jagobandhusome/STM32_OBC_Cube_Sat_Firmware/CubeSat_OBC_Assets/console.png

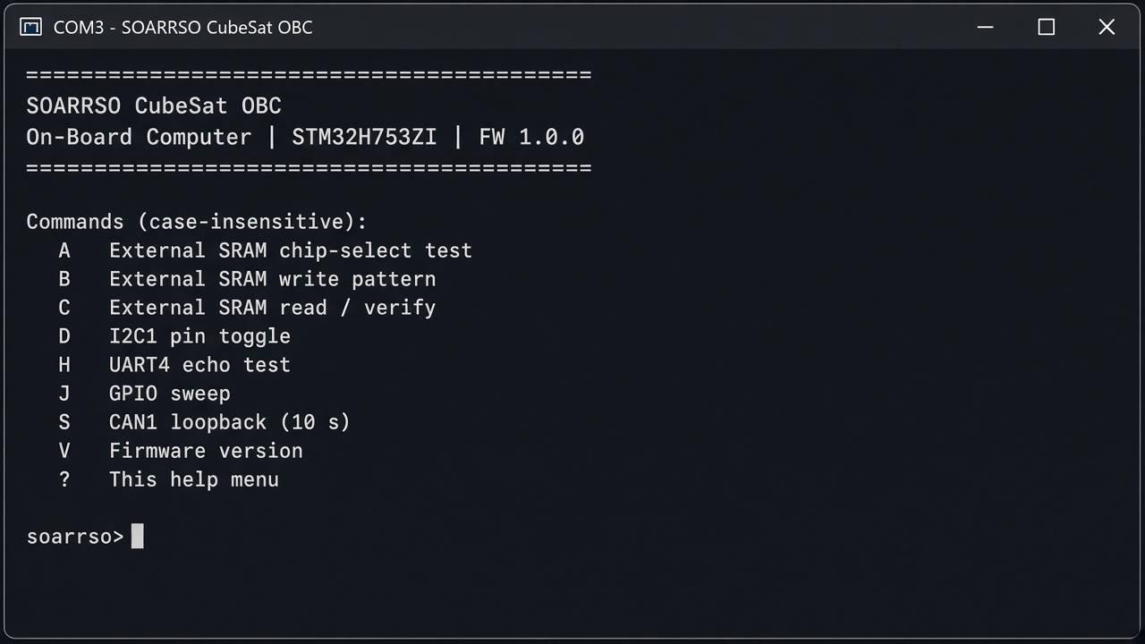
CubeSat_OBC_Assets/console.png
