jagobandhusome/STM32_OBC_Cube_Sat_Firmware/CubeSat_OBC_Hardware/CAD/CubeSat_OBC_PCB.brd

## EAGLE design CubeSat_OBC_Hardware/CAD/CubeSat_OBC_PCB.brd (2026-09-12)

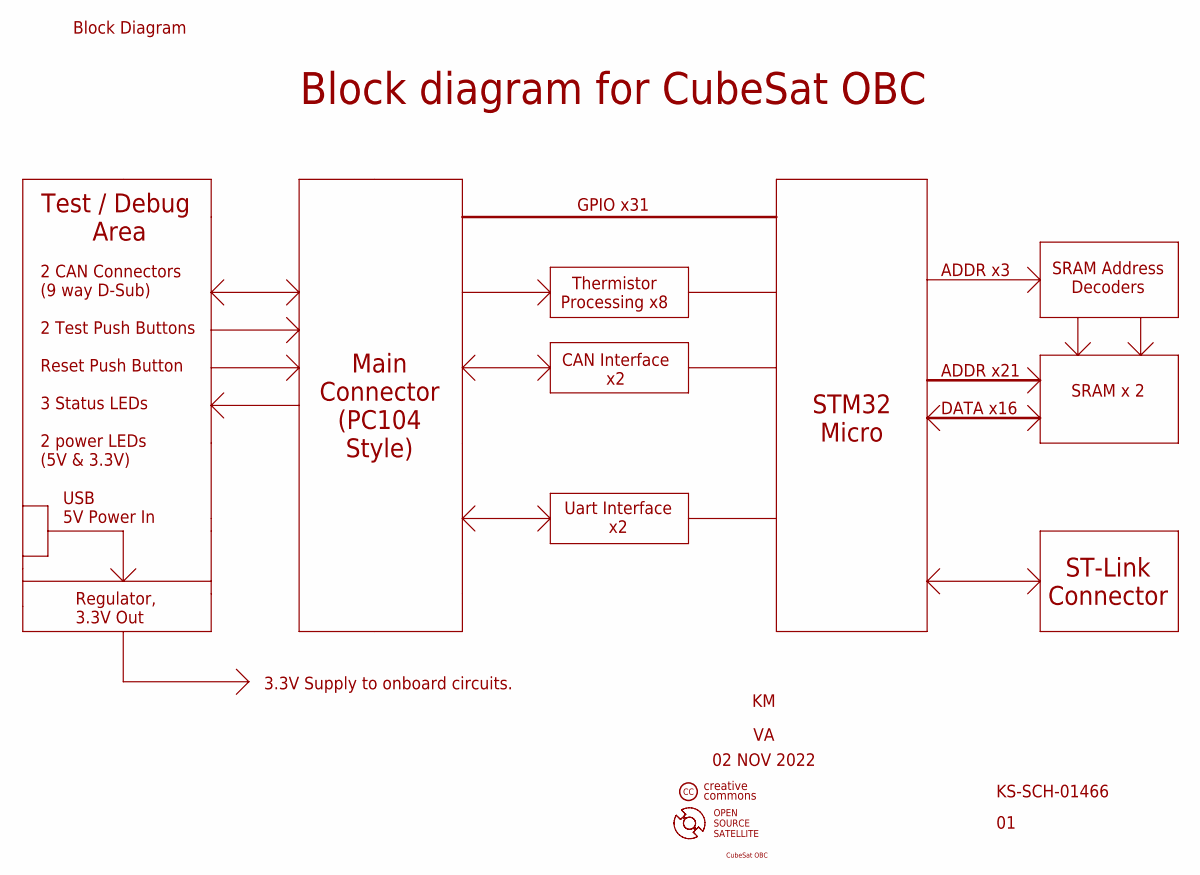
[picture p2: schematic CubeSat_OBC_Schematic.sch, sheet 1, Block Diagram]

Notes on the sheet:
Block Diagram
Main Connector (PC104 Style)
STM32 Micro
Thermistor Processing x8
CAN Interface x2
Uart Interface x2
KS-SCH-01466
SRAM Address Decoders
SRAM x 2
ST-Link Connector
ADDR x21
DATA x16
ADDR x3
GPIO x31
Block diagram for CubeSat OBC
02 NOV 2022
Test / Debug Area
Regulator, 3.3V Out
USB 5V Power In
3.3V Supply to onboard circuits.
2 CAN Connectors (9 way D-Sub) 2 Test Push Buttons Reset Push Button 3 Status LEDs 2 power LEDs (5V & 3.3V)
OPEN SOURCE SATELLITE
creative commons
CubeSat OBC

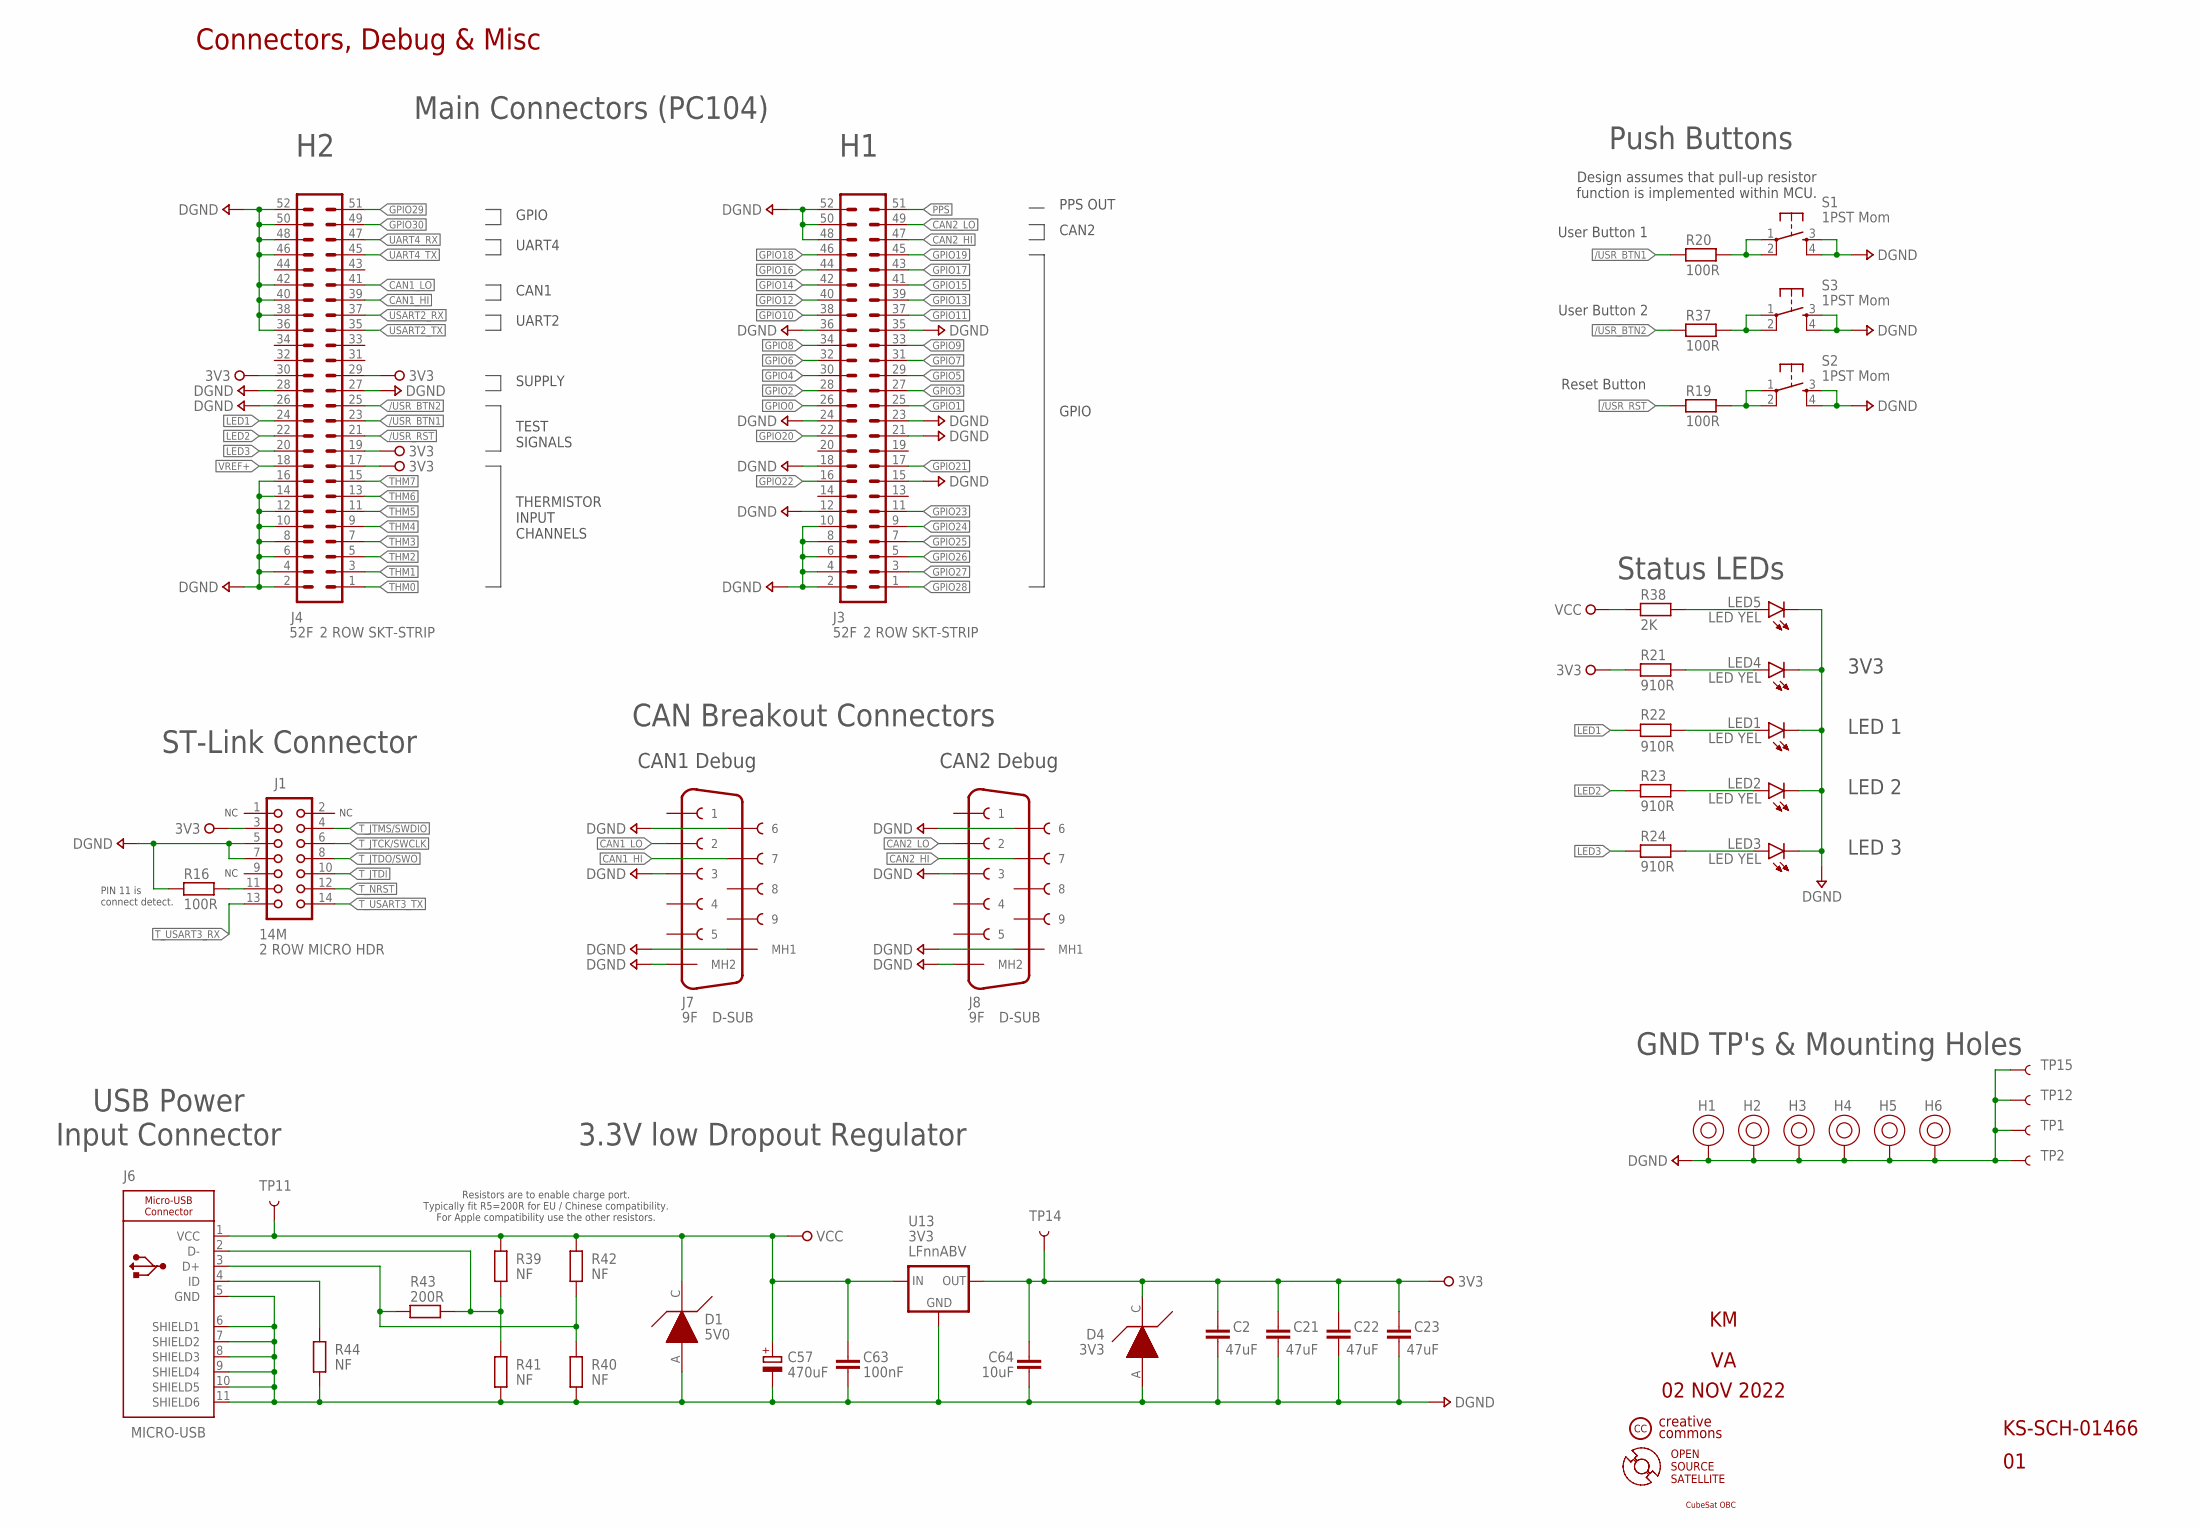
[picture p3: schematic CubeSat_OBC_Schematic.sch, sheet 2, Connectors & Misc]

Parts:
C2, C21, C22, C23: 47uF; CAPC3225X135_1210
C57: 470uF; CAP_ELECT_RADIAL_D10_H12.5_P5
C63: 100nF; CAP_CHIP_0805
C64: 10uF; CAPC3225X135_1210
D1: 5V0; SOD323
D4: 3V3; SOD323
H1, H2, H3, H4, H5, H6: NF; HOLE-PTH-3.2-6.35
J1: 14M; HDRV14W41P127_2X7_FTSH
J3, J4: 52F; HDRVR52W64P254_2X26_6655X495X1105B
J6: CNRP105A_MICRO-USB_90DEG; CON_MICRO_USB_FEMALE
J7, J8: 9F; LD09S24A4GV00LF
LED1, LED2, LED3, LED4, LED5: OPTL102A_LED_YELLOW_0805_120DEG; LED_CHIP_0805
R16, R19, R20, R37: 100R; RES_CHIP_0805
R21, R22, R23, R24: 910R; RES_CHIP_0805
R38: 2K; RES_CHIP_0805
R39, R40, R41, R42, R44: NF; RES_CHIP_0805
R43: 200R; RES_CHIP_0805
S1, S2, S3: SWTA100A_1PST_SMD_MOMENTARY_PUSH-BUTTON; TACTILE_SWITCH_SMD_5.2MM
TP1, TP2, TP11, TP12, TP14, TP15: NF; TP-40TH
U13: 3V3; TO220L1A

Connections:
3V3: C2.1, C21.1, C22.1, C23.1, C64.1, D4.C (K), J1.3, J4.17, J4.19, J4.29, J4.30, R21.1, TP14.P$1, U13.3 (OUT); also elsewhere on the board
/USR_BTN1: J4.23, R20.2; also elsewhere on the board
/USR_BTN2: J4.25, R37.2; also elsewhere on the board
/USR_RST: J4.21, R19.2; also elsewhere on the board
CAN1_HI: J4.39, J7.7; also elsewhere on the board
CAN1_LO: J4.41, J7.2; also elsewhere on the board
CAN2_HI: J3.47, J8.7; also elsewhere on the board
CAN2_LO: J3.49, J8.2; also elsewhere on the board
DGND: C2.2, C21.2, C22.2, C23.2, C57.2 (-), C63.2, C64.2, D1.A, D4.A, H1.P$1, H2.P$1, H3.P$1, H4.P$1, H5.P$1, H6.P$1, J1.5, J1.7, J3.2, J3.4, J3.6, J3.8, J3.10, J3.12, J3.15, J3.18, J3.21, J3.23, J3.24, J3.35, J3.36, J3.48, J3.50, J3.52, J4.2, J4.4, J4.6, J4.8, J4.10, J4.12, J4.14, J4.16, J4.26, J4.27, J4.28, J4.36, J4.38, J4.40, J4.42, J4.46, J4.48, J4.50, J4.52, J6.5 (GND), J6.6 (SHIELD1), J6.7 (SHIELD2), J6.8 (SHIELD3), J6.9 (SHIELD4), J6.10 (SHIELD5), J6.11 (SHIELD6), J7.3, J7.6, J7.MH1 (MH2), J7.MH2 (MH1), J8.3, J8.6, J8.MH1 (MH2), J8.MH2 (MH1), LED1.C, LED2.C, LED3.C, LED4.C, LED5.C, R16.1, R40.1, R41.1, R44.1, S1.3, S1.4, S2.3, S2.4, S3.3, S3.4, TP1.P$1, TP2.P$1, TP12.P$1, TP15.P$1, U13.2 (GND); also elsewhere on the board
GPIO0: J3.26; also elsewhere on the board
GPIO1: J3.25; also elsewhere on the board
GPIO2: J3.28; also elsewhere on the board
GPIO3: J3.27; also elsewhere on the board
GPIO4: J3.30; also elsewhere on the board
GPIO5: J3.29; also elsewhere on the board
GPIO6: J3.32; also elsewhere on the board
GPIO7: J3.31; also elsewhere on the board
GPIO8: J3.34; also elsewhere on the board
GPIO9: J3.33; also elsewhere on the board
GPIO10: J3.38; also elsewhere on the board
GPIO11: J3.37; also elsewhere on the board
GPIO12: J3.40; also elsewhere on the board
GPIO13: J3.39; also elsewhere on the board
GPIO14: J3.42; also elsewhere on the board
GPIO15: J3.41; also elsewhere on the board
GPIO16: J3.44; also elsewhere on the board
GPIO17: J3.43; also elsewhere on the board
GPIO18: J3.46; also elsewhere on the board
GPIO19: J3.45; also elsewhere on the board
GPIO20: J3.22; also elsewhere on the board
GPIO21: J3.17; also elsewhere on the board
GPIO22: J3.16; also elsewhere on the board
GPIO23: J3.11; also elsewhere on the board
GPIO24: J3.9; also elsewhere on the board
GPIO25: J3.7; also elsewhere on the board
GPIO26: J3.5; also elsewhere on the board
GPIO27: J3.3; also elsewhere on the board
GPIO28: J3.1; also elsewhere on the board
GPIO29: J4.51; also elsewhere on the board
GPIO30: J4.49; also elsewhere on the board
LED1: J4.24, R22.1; also elsewhere on the board
LED2: J4.22, R23.1; also elsewhere on the board
LED3: J4.20, R24.1; also elsewhere on the board
unnamed: R19.1, S2.1, S2.2
unnamed: J1.11, R16.2
unnamed: R20.1, S1.1, S1.2
unnamed: LED4.A, R21.2
unnamed: LED1.A, R22.2
unnamed: LED2.A, R23.2
unnamed: LED3.A, R24.2
unnamed: R37.1, S3.1, S3.2
unnamed: LED5.A, R38.2
unnamed: J6.3 (D+), R40.2, R42.1, R43.1
unnamed: J6.2 (D-), R39.1, R41.2, R43.2
unnamed: J6.4 (ID), R44.2
PPS: J3.51; also elsewhere on the board
THM0: J4.1; also elsewhere on the board
THM1: J4.3; also elsewhere on the board
THM2: J4.5; also elsewhere on the board
THM3: J4.7; also elsewhere on the board
THM4: J4.9; also elsewhere on the board
THM5: J4.11; also elsewhere on the board
THM6: J4.13; also elsewhere on the board
THM7: J4.15; also elsewhere on the board
T_JTCK/SWCLK: J1.6; also elsewhere on the board
T_JTDI: J1.10; also elsewhere on the board
T_JTDO/SWO: J1.8; also elsewhere on the board
T_JTMS/SWDIO: J1.4; also elsewhere on the board
T_NRST: J1.12; also elsewhere on the board
T_USART3_RX: J1.13; also elsewhere on the board
T_USART3_TX: J1.14; also elsewhere on the board
UART4_RX: J4.47; also elsewhere on the board
UART4_TX: J4.45; also elsewhere on the board
USART2_RX: J4.37; also elsewhere on the board
USART2_TX: J4.35; also elsewhere on the board
VCC: C57.1 (+), C63.1, D1.C (K), J6.1 (VCC), R38.1, R39.2, R42.2, TP11.P$1, U13.1 (IN)
VREF+: J4.18; also elsewhere on the board

Notes on the sheet:
KS-SCH-01466
Connectors, Debug & Misc
ST-Link Connector
Main Connectors (PC104)
PIN 11 is connect detect.
GND TP's & Mounting Holes
THERMISTOR INPUT CHANNELS
TEST SIGNALS
SUPPLY
CAN1
GPIO
CAN2
02 NOV 2022
CAN Breakout Connectors
CAN1 Debug
CAN2 Debug
3.3V low Dropout Regulator
Resistors are to enable charge port. Typically fit R5=200R for EU / Chinese compatibility. For Apple compatibility use the other resistors.
USB Power Input Connector
User Button 1
Reset Button
Status LEDs
3V3
LED 1
LED 2
LED 3
User Button 2
Push Buttons
Design assumes that pull-up resistor function is implemented within MCU.
UART4
UART2
PPS OUT
OPEN SOURCE SATELLITE
creative commons
CubeSat OBC

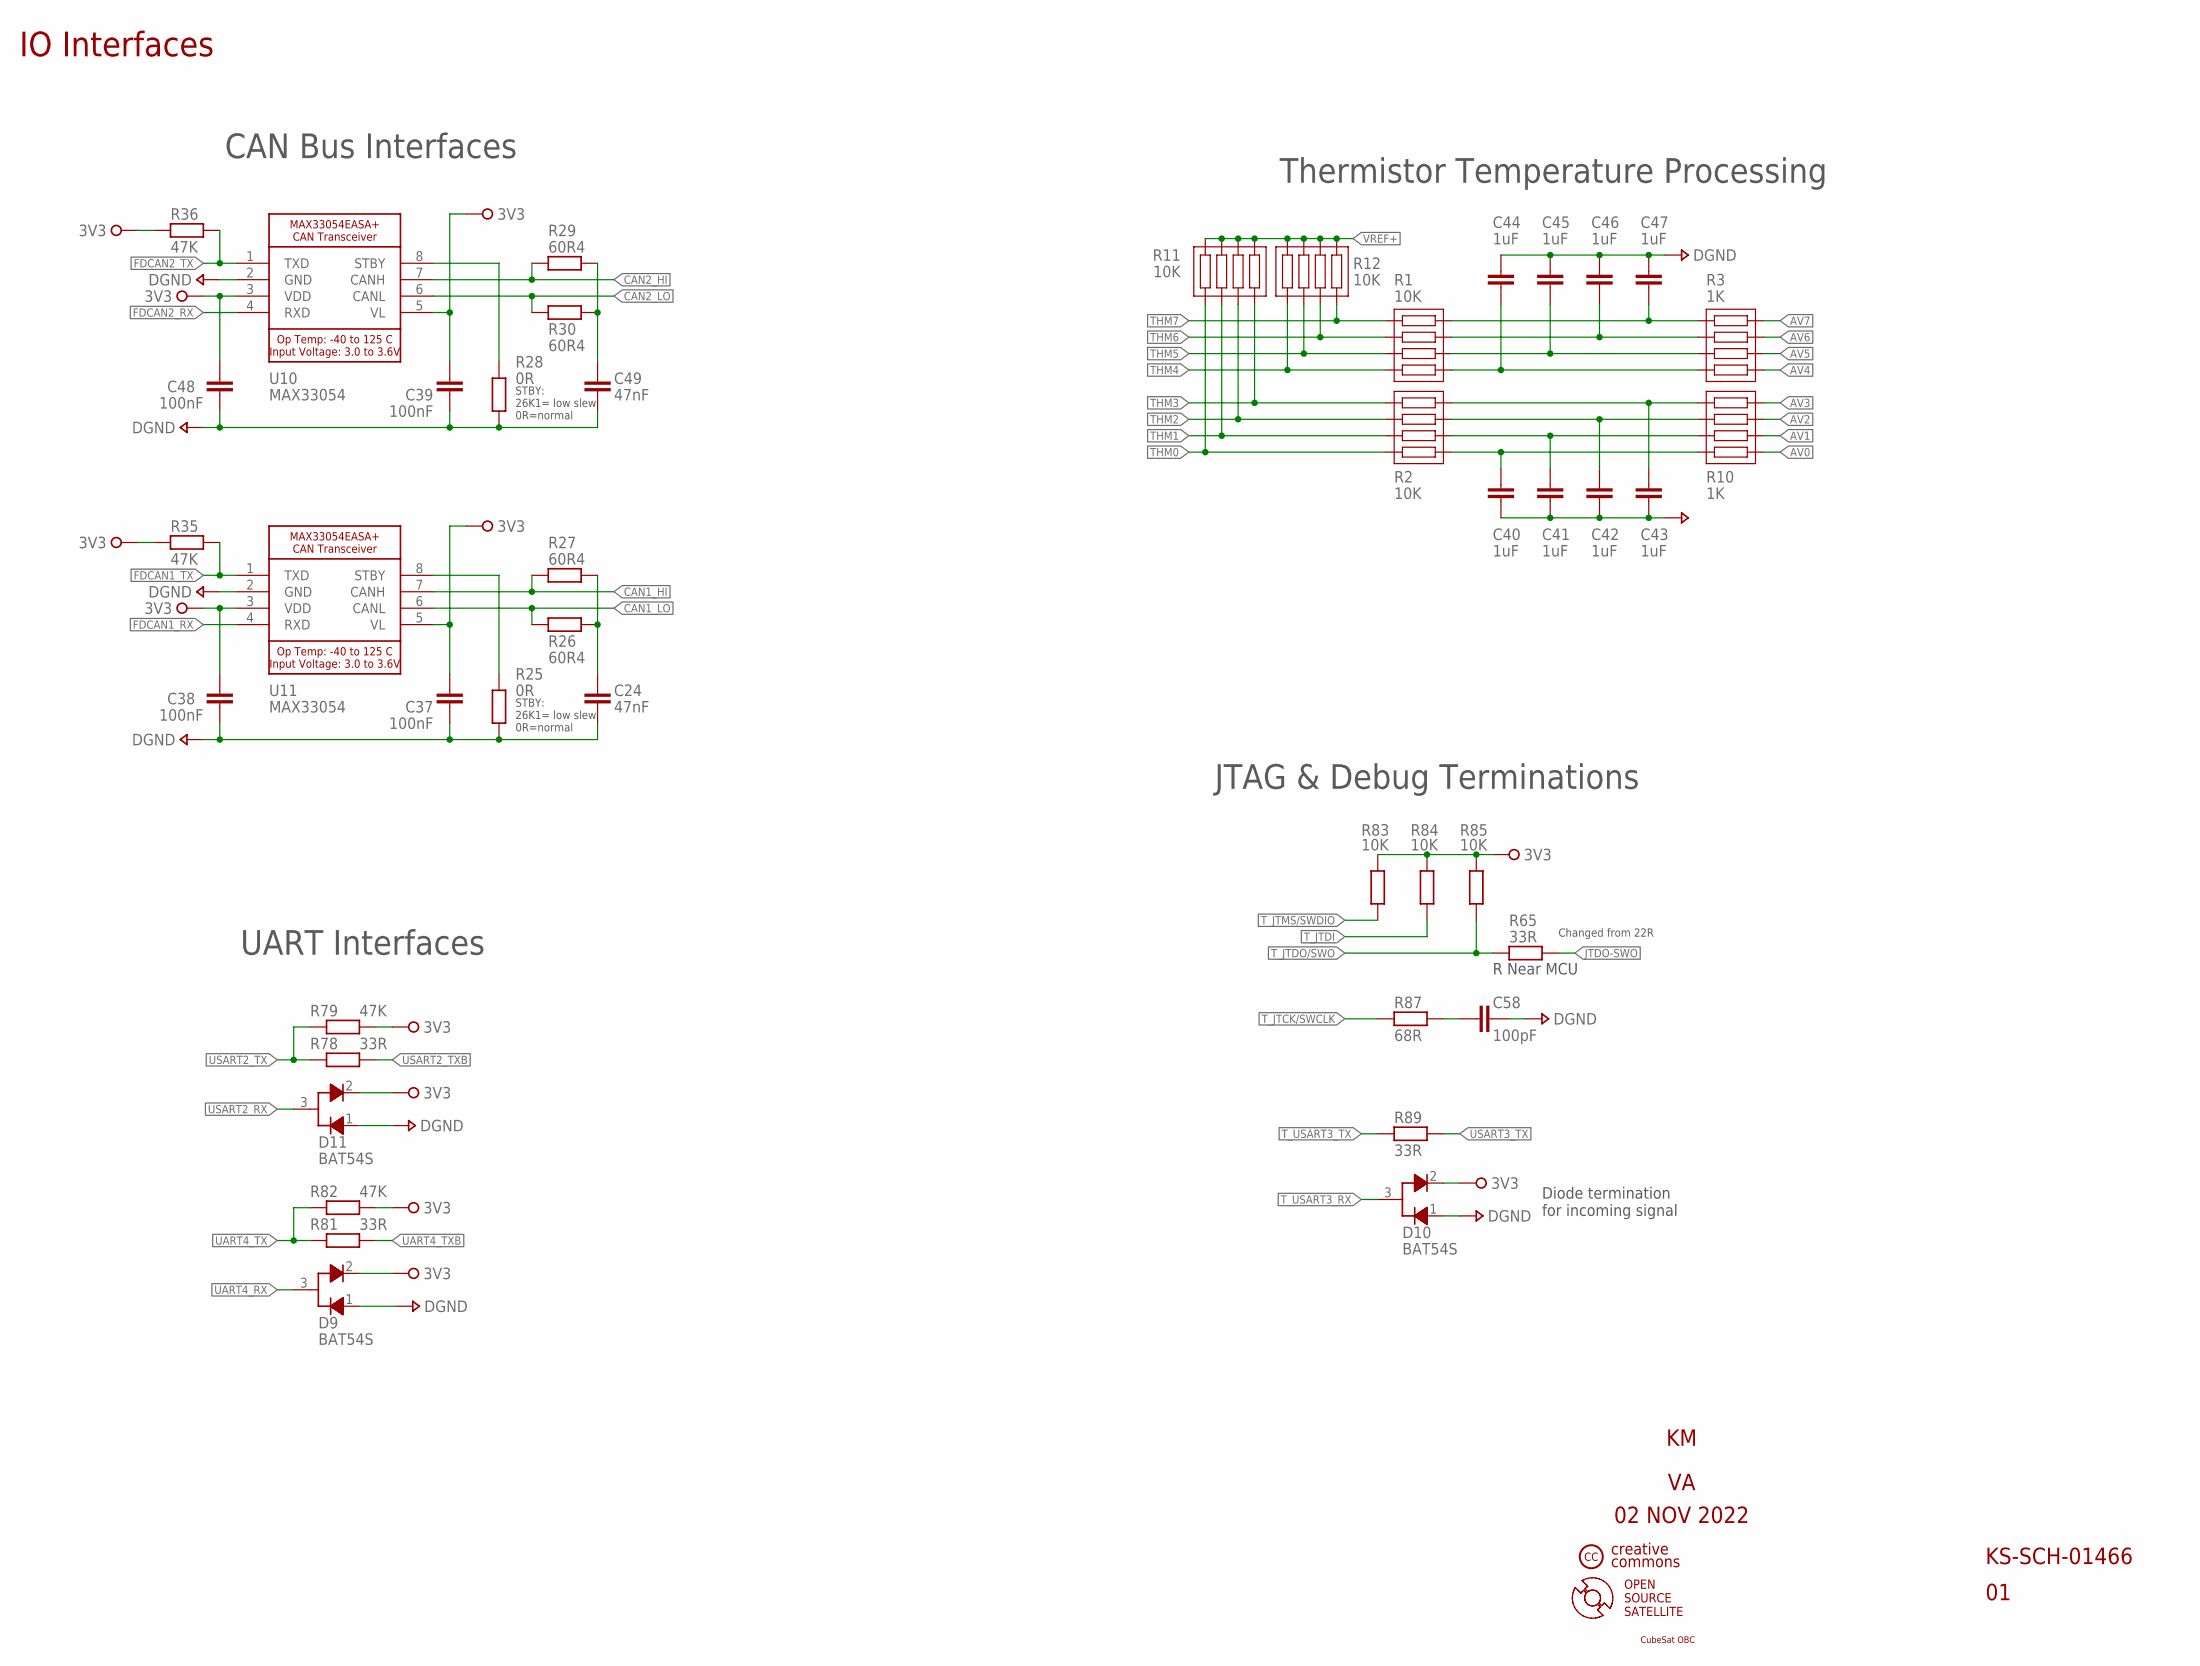
[picture p4: schematic CubeSat_OBC_Schematic.sch, sheet 3, Sub-System Busses]

Parts:
C24, C49: 47nF; CAP_CHIP_0805
C37, C38, C39, C48: 100nF; CAP_CHIP_0805
C40, C41, C42, C43, C44, C45, C46, C47: 1uF; CAP_CHIP_0805
C58: 100pF; CAP_CHIP_0805
D9, D10, D11: DIOC100A_BAT54S_DUAL_SCHOTTKY; SOT23
R1, R2, R11, R12: 10K; RESCAXS80P320X160X60-8N
R3, R10: 1K; RESCAXS80P320X160X60-8N
R25, R28: 0R; RES_CHIP_0805
R26, R27, R29, R30: 60R4; RES_CHIP_0805
R35, R36, R79, R82: 47K; RES_CHIP_0805
R65, R78, R81, R89: 33R; RES_CHIP_0805
R83, R84, R85: 10K; RES_CHIP_0805
R87: 68R; RES_CHIP_0805
U10, U11: ICTT100A_MAX33054EASA+_CAN-TRANCEIVER; IC_MAX33054EASA+

Connections:
3V3: C37.2, C38.2, C39.2, C48.2, D9.2, D10.2, D11.2, R35.2, R36.2, R79.2, R82.2, R83.2, R84.2, R85.2, U10.3 (VDD), U10.5 (VL), U11.3 (VDD), U11.5 (VL); also elsewhere on the board
AV0: R10.5; also elsewhere on the board
AV1: R10.6; also elsewhere on the board
AV2: R10.7; also elsewhere on the board
AV3: R10.8; also elsewhere on the board
AV4: R3.5; also elsewhere on the board
AV5: R3.6; also elsewhere on the board
AV6: R3.7; also elsewhere on the board
AV7: R3.8; also elsewhere on the board
CAN1_HI: R27.1, U11.7 (CANH); also elsewhere on the board
CAN1_LO: R26.1, U11.6 (CANL); also elsewhere on the board
CAN2_HI: R29.1, U10.7 (CANH); also elsewhere on the board
CAN2_LO: R30.1, U10.6 (CANL); also elsewhere on the board
DGND: C24.1, C37.1, C38.1, C39.1, C40.2, C41.2, C42.2, C43.2, C44.1, C45.1, C46.1, C47.1, C48.1, C49.1, C58.2, D9.1, D10.1, D11.1, R25.1, R28.1, U10.2 (GND), U11.2 (GND); also elsewhere on the board
FDCAN1_RX: U11.4 (RXD); also elsewhere on the board
FDCAN1_TX: R35.1, U11.1 (TXD); also elsewhere on the board
FDCAN2_RX: U10.4 (RXD); also elsewhere on the board
FDCAN2_TX: R36.1, U10.1 (TXD); also elsewhere on the board
JTDO-SWO: R65.2; also elsewhere on the board
L_CSN+1: C40.1, R2.5, R10.4
L_CSN+10: C41.1, R2.6, R10.3
L_CSN+11: C42.1, R2.7, R10.2
L_CSN+12: C43.1, R2.8, R10.1
L_CSN+13: C44.2, R1.5, R3.4
L_CSN+14: C45.2, R1.6, R3.3
L_CSN+15: C46.2, R1.7, R3.2
L_CSN+16: C47.2, R1.8, R3.1
unnamed: C58.1, R87.2
unnamed: C24.2, R26.2, R27.2
unnamed: R25.2, U11.8 (STBY)
unnamed: R28.2, U10.8 (STBY)
unnamed: C49.2, R29.2, R30.2
THM0: R2.4, R11.5; also elsewhere on the board
THM1: R2.3, R11.6; also elsewhere on the board
THM2: R2.2, R11.7; also elsewhere on the board
THM3: R2.1, R11.8; also elsewhere on the board
THM4: R1.4, R12.5; also elsewhere on the board
THM5: R1.3, R12.6; also elsewhere on the board
THM6: R1.2, R12.7; also elsewhere on the board
THM7: R1.1, R12.8; also elsewhere on the board
T_JTCK/SWCLK: R87.1; also elsewhere on the board
T_JTDI: R84.1; also elsewhere on the board
T_JTDO/SWO: R65.1, R85.1; also elsewhere on the board
T_JTMS/SWDIO: R83.1; also elsewhere on the board
T_USART3_RX: D10.3; also elsewhere on the board
T_USART3_TX: R89.1; also elsewhere on the board
UART4_RX: D9.3; also elsewhere on the board
UART4_TX: R81.1, R82.1; also elsewhere on the board
UART4_TXB: R81.2; also elsewhere on the board
USART2_RX: D11.3; also elsewhere on the board
USART2_TX: R78.1, R79.1; also elsewhere on the board
USART2_TXB: R78.2; also elsewhere on the board
USART3_TX: R89.2; also elsewhere on the board
VREF+: R11.1, R11.2, R11.3, R11.4, R12.1, R12.2, R12.3, R12.4; also elsewhere on the board

Notes on the sheet:
IO Interfaces
STBY: 26K1= low slew 0R=normal
CAN Bus Interfaces
UART Interfaces
KS-SCH-01466
02 NOV 2022
Thermistor Temperature Processing
JTAG & Debug Terminations
R Near MCU
Diode termination for incoming signal
Changed from 22R
OPEN SOURCE SATELLITE
creative commons
CubeSat OBC

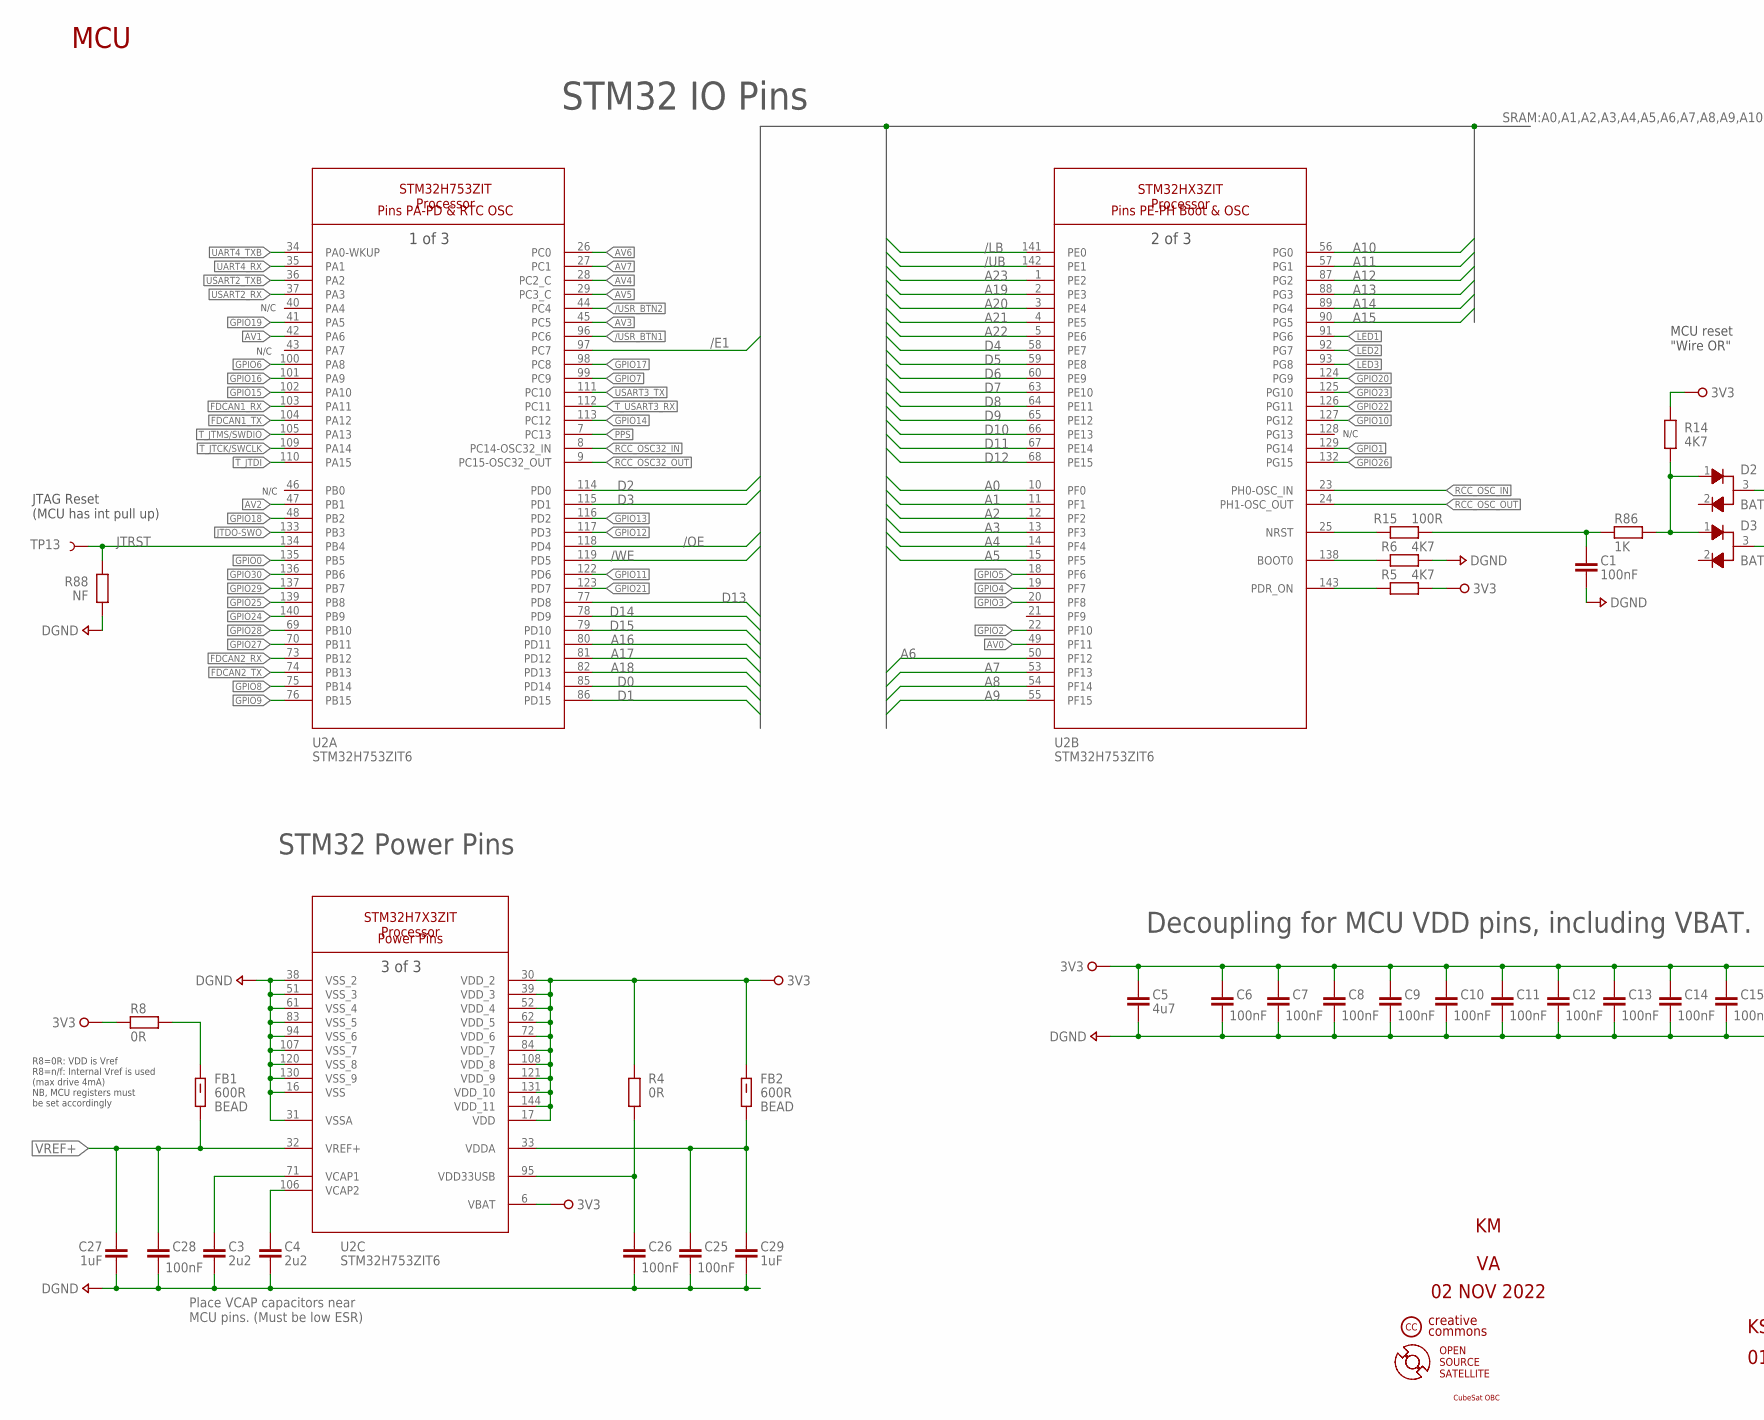
[picture p5: schematic CubeSat_OBC_Schematic.sch, sheet 4, MCU, part in row 1, column 1]

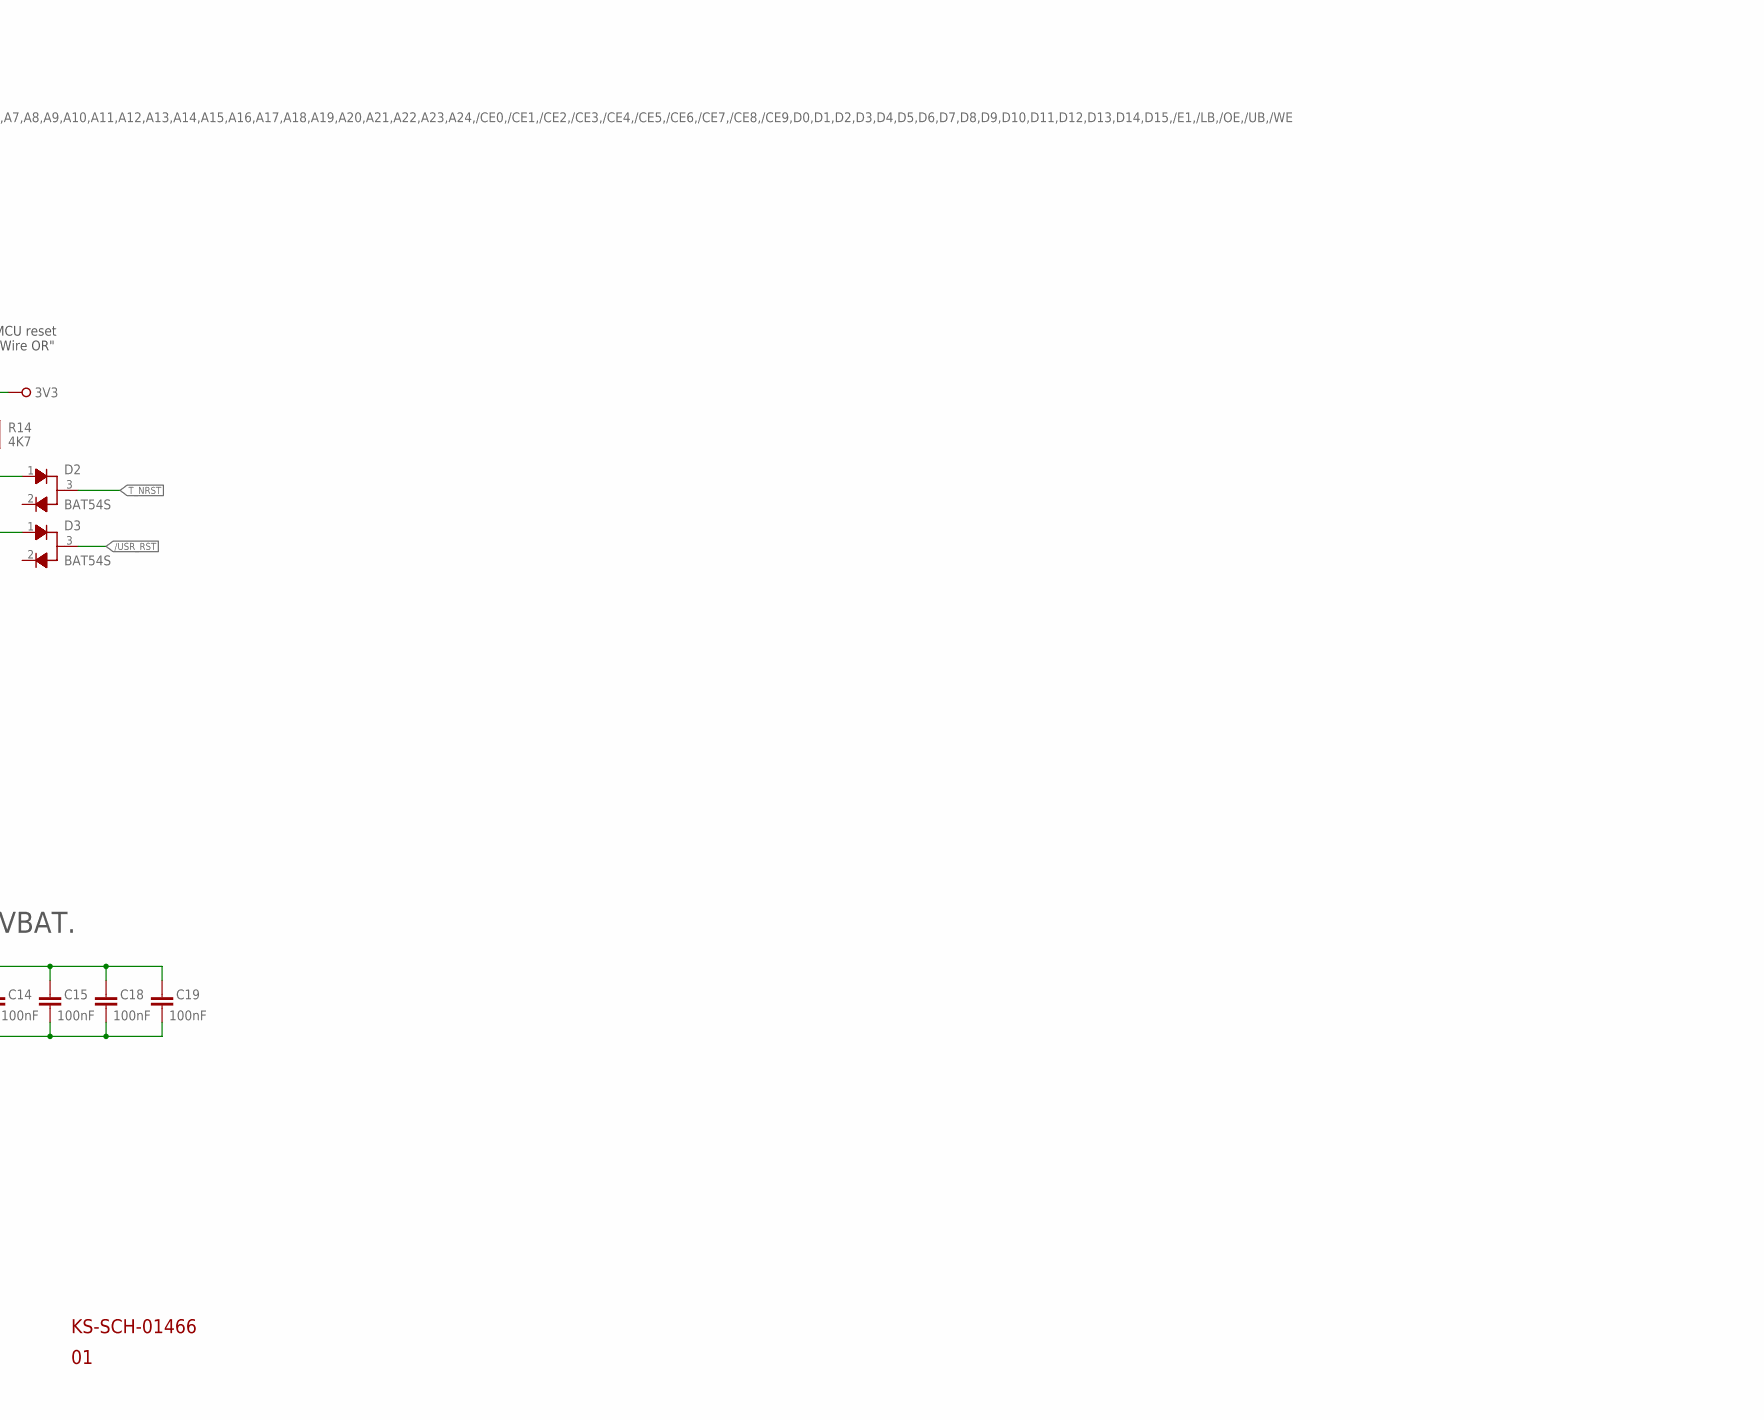
[picture p6: schematic CubeSat_OBC_Schematic.sch, sheet 4, MCU, part in row 1, column 2]

Parts:
C1, C6, C7, C8, C9, C10, C11, C12, C13, C14, C15, C18, C19, C25, C26, C28: 100nF; CAP_CHIP_0805
C3, C4: 2u2; CAP_CHIP_0805
C5: 4u7; CAP_CHIP_0805
C27, C29: 1uF; CAP_CHIP_0805
D2, D3: DIOC100A_BAT54S_DUAL_SCHOTTKY; SOT23
FB1, FB2: 600R; BEADC2012X105N
R4, R8: 0R; RES_CHIP_0805
R5, R6, R14: 4K7; RES_CHIP_0805
R15: 100R; RES_CHIP_0805
R86: 1K; RES_CHIP_0805
R88: NF; RES_CHIP_0805
TP13: NF; TP-40TH
U2: ICTP100A_STM32H753ZIT6_MCU_144PIN; IC_STM32H753ZIT6

Connections:
3V3: C5.1, C6.1, C7.1, C8.1, C9.1, C10.1, C11.1, C12.1, C13.1, C14.1, C15.1, C18.1, C19.1, FB2.2, R4.2, R5.1, R8.2, R14.1, U2.6 (VBAT), U2.17 (VDD), U2.30 (VDD_2), U2.39 (VDD_3), U2.52 (VDD_4), U2.62 (VDD_5), U2.72 (VDD_6), U2.84 (VDD_7), U2.108 (VDD_8), U2.121 (VDD_9), U2.131 (VDD_10), U2.144 (VDD_11); also elsewhere on the board
/E1: U2.97 (PC7); also elsewhere on the board
/LB: U2.141 (PE0); also elsewhere on the board
/OE: U2.118 (PD4); also elsewhere on the board
/UB: U2.142 (PE1); also elsewhere on the board
/USR_BTN1: U2.96 (PC6); also elsewhere on the board
/USR_BTN2: U2.44 (PC4); also elsewhere on the board
/USR_RST: D3.3; also elsewhere on the board
/WE: U2.119 (PD5); also elsewhere on the board
A0: U2.10 (PF0); also elsewhere on the board
A1: U2.11 (PF1); also elsewhere on the board
A2: U2.12 (PF2); also elsewhere on the board
A3: U2.13 (PF3); also elsewhere on the board
A4: U2.14 (PF4); also elsewhere on the board
A5: U2.15 (PF5); also elsewhere on the board
A6: U2.50 (PF12); also elsewhere on the board
A7: U2.53 (PF13); also elsewhere on the board
A8: U2.54 (PF14); also elsewhere on the board
A9: U2.55 (PF15); also elsewhere on the board
A10: U2.56 (PG0); also elsewhere on the board
A11: U2.57 (PG1); also elsewhere on the board
A12: U2.87 (PG2); also elsewhere on the board
A13: U2.88 (PG3); also elsewhere on the board
A14: U2.89 (PG4); also elsewhere on the board
A15: U2.90 (PG5); also elsewhere on the board
A16: U2.80 (PD11); also elsewhere on the board
A17: U2.81 (PD12); also elsewhere on the board
A18: U2.82 (PD13); also elsewhere on the board
A19: U2.2 (PE3); also elsewhere on the board
A20: U2.3 (PE4); also elsewhere on the board
A21: U2.4 (PE5); also elsewhere on the board
A22: U2.5 (PE6); also elsewhere on the board
A23: U2.1 (PE2); also elsewhere on the board
AV0: U2.49 (PF11); also elsewhere on the board
AV1: U2.42 (PA6); also elsewhere on the board
AV2: U2.47 (PB1); also elsewhere on the board
AV3: U2.45 (PC5); also elsewhere on the board
AV4: U2.28 (PC2_C); also elsewhere on the board
AV5: U2.29 (PC3_C); also elsewhere on the board
AV6: U2.26 (PC0); also elsewhere on the board
AV7: U2.27 (PC1); also elsewhere on the board
BOOT0: R6.2, U2.138 (BOOT0)
D0: U2.85 (PD14); also elsewhere on the board
D1: U2.86 (PD15); also elsewhere on the board
D2: U2.114 (PD0); also elsewhere on the board
D3: U2.115 (PD1); also elsewhere on the board
D4: U2.58 (PE7); also elsewhere on the board
D5: U2.59 (PE8); also elsewhere on the board
D6: U2.60 (PE9); also elsewhere on the board
D7: U2.63 (PE10); also elsewhere on the board
D8: U2.64 (PE11); also elsewhere on the board
D9: U2.65 (PE12); also elsewhere on the board
D10: U2.66 (PE13); also elsewhere on the board
D11: U2.67 (PE14); also elsewhere on the board
D12: U2.68 (PE15); also elsewhere on the board
D13: U2.77 (PD8); also elsewhere on the board
D14: U2.78 (PD9); also elsewhere on the board
D15: U2.79 (PD10); also elsewhere on the board
DGND: C1.2, C3.2, C4.2, C5.2, C6.2, C7.2, C8.2, C9.2, C10.2, C11.2, C12.2, C13.2, C14.2, C15.2, C18.2, C19.2, C25.2, C26.2, C27.2, C28.2, C29.2, R6.1, R88.1, U2.16 (VSS), U2.31 (VSSA), U2.38 (VSS_2), U2.51 (VSS_3), U2.61 (VSS_4), U2.83 (VSS_5), U2.94 (VSS_6), U2.107 (VSS_7), U2.120 (VSS_8), U2.130 (VSS_9); also elsewhere on the board
FDCAN1_RX: U2.103 (PA11); also elsewhere on the board
FDCAN1_TX: U2.104 (PA12); also elsewhere on the board
FDCAN2_RX: U2.73 (PB12); also elsewhere on the board
FDCAN2_TX: U2.74 (PB13); also elsewhere on the board
GPIO0: U2.135 (PB5); also elsewhere on the board
GPIO1: U2.129 (PG14); also elsewhere on the board
GPIO2: U2.22 (PF10); also elsewhere on the board
GPIO3: U2.20 (PF8); also elsewhere on the board
GPIO4: U2.19 (PF7); also elsewhere on the board
GPIO5: U2.18 (PF6); also elsewhere on the board
GPIO6: U2.100 (PA8); also elsewhere on the board
GPIO7: U2.99 (PC9); also elsewhere on the board
GPIO8: U2.75 (PB14); also elsewhere on the board
GPIO9: U2.76 (PB15); also elsewhere on the board
GPIO10: U2.127 (PG12); also elsewhere on the board
GPIO11: U2.122 (PD6); also elsewhere on the board
GPIO12: U2.117 (PD3); also elsewhere on the board
GPIO13: U2.116 (PD2); also elsewhere on the board
GPIO14: U2.113 (PC12); also elsewhere on the board
GPIO15: U2.102 (PA10); also elsewhere on the board
GPIO16: U2.101 (PA9); also elsewhere on the board
GPIO17: U2.98 (PC8); also elsewhere on the board
GPIO18: U2.48 (PB2); also elsewhere on the board
GPIO19: U2.41 (PA5); also elsewhere on the board
GPIO20: U2.124 (PG9); also elsewhere on the board
GPIO21: U2.123 (PD7); also elsewhere on the board
GPIO22: U2.126 (PG11); also elsewhere on the board
GPIO23: U2.125 (PG10); also elsewhere on the board
GPIO24: U2.140 (PB9); also elsewhere on the board
GPIO25: U2.139 (PB8); also elsewhere on the board
GPIO26: U2.132 (PG15); also elsewhere on the board
GPIO27: U2.70 (PB11); also elsewhere on the board
GPIO28: U2.69 (PB10); also elsewhere on the board
GPIO29: U2.137 (PB7); also elsewhere on the board
GPIO30: U2.136 (PB6); also elsewhere on the board
JTDO-SWO: U2.133 (PB3); also elsewhere on the board
JTRST: R88.2, TP13.P$1, U2.134 (PB4)
LED1: U2.91 (PG6); also elsewhere on the board
LED2: U2.92 (PG7); also elsewhere on the board
LED3: U2.93 (PG8); also elsewhere on the board
unnamed: C26.1, R4.1, U2.95 (VDD33USB)
unnamed: FB1.2, R8.1
unnamed: C25.1, C29.1, FB2.1, U2.33 (VDDA)
unnamed: C4.1, U2.106 (VCAP2)
unnamed: C3.1, U2.71 (VCAP1)
unnamed: R15.2, U2.25 (NRST)
unnamed: D2.1, D3.1, R14.2, R86.2
unnamed: R5.2, U2.143 (PDR_ON)
unnamed: C1.1, R15.1, R86.1
PPS: U2.7 (PC13); also elsewhere on the board
RCC_OSC32_IN: U2.8 (PC14-OSC32_IN); also elsewhere on the board
RCC_OSC32_OUT: U2.9 (PC15-OSC32_OUT); also elsewhere on the board
RCC_OSC_IN: U2.23 (PH0-OSC_IN); also elsewhere on the board
RCC_OSC_OUT: U2.24 (PH1-OSC_OUT); also elsewhere on the board
T_JTCK/SWCLK: U2.109 (PA14); also elsewhere on the board
T_JTDI: U2.110 (PA15); also elsewhere on the board
T_JTMS/SWDIO: U2.105 (PA13); also elsewhere on the board
T_NRST: D2.3; also elsewhere on the board
T_USART3_RX: U2.112 (PC11); also elsewhere on the board
UART4_RX: U2.35 (PA1); also elsewhere on the board
UART4_TXB: U2.34 (PA0-WKUP); also elsewhere on the board
USART2_RX: U2.37 (PA3); also elsewhere on the board
USART2_TXB: U2.36 (PA2); also elsewhere on the board
USART3_TX: U2.111 (PC10); also elsewhere on the board
VREF+: C27.1, C28.1, FB1.1, U2.32 (VREF+); also elsewhere on the board

Notes on the sheet:
Decoupling for MCU VDD pins, including VBAT.
STM32 IO Pins
Place VCAP capacitors near MCU pins. (Must be low ESR)
STM32 Power Pins
R8=0R: VDD is Vref R8=n/f: Internal Vref is used (max drive 4mA) NB, MCU registers must be set accordingly
N/C
MCU reset "Wire OR"
KS-SCH-01466
MCU
02 NOV 2022
JTAG Reset (MCU has int pull up)
OPEN SOURCE SATELLITE
creative commons
CubeSat OBC
