jagobandhusome/STM32_OBC_Cube_Sat_Firmware/CubeSat_OBC_Hardware/CAD/CubeSat_OBC_PCB.brd

## EAGLE design CubeSat_OBC_Hardware/CAD/CubeSat_OBC_PCB.brd (continued)

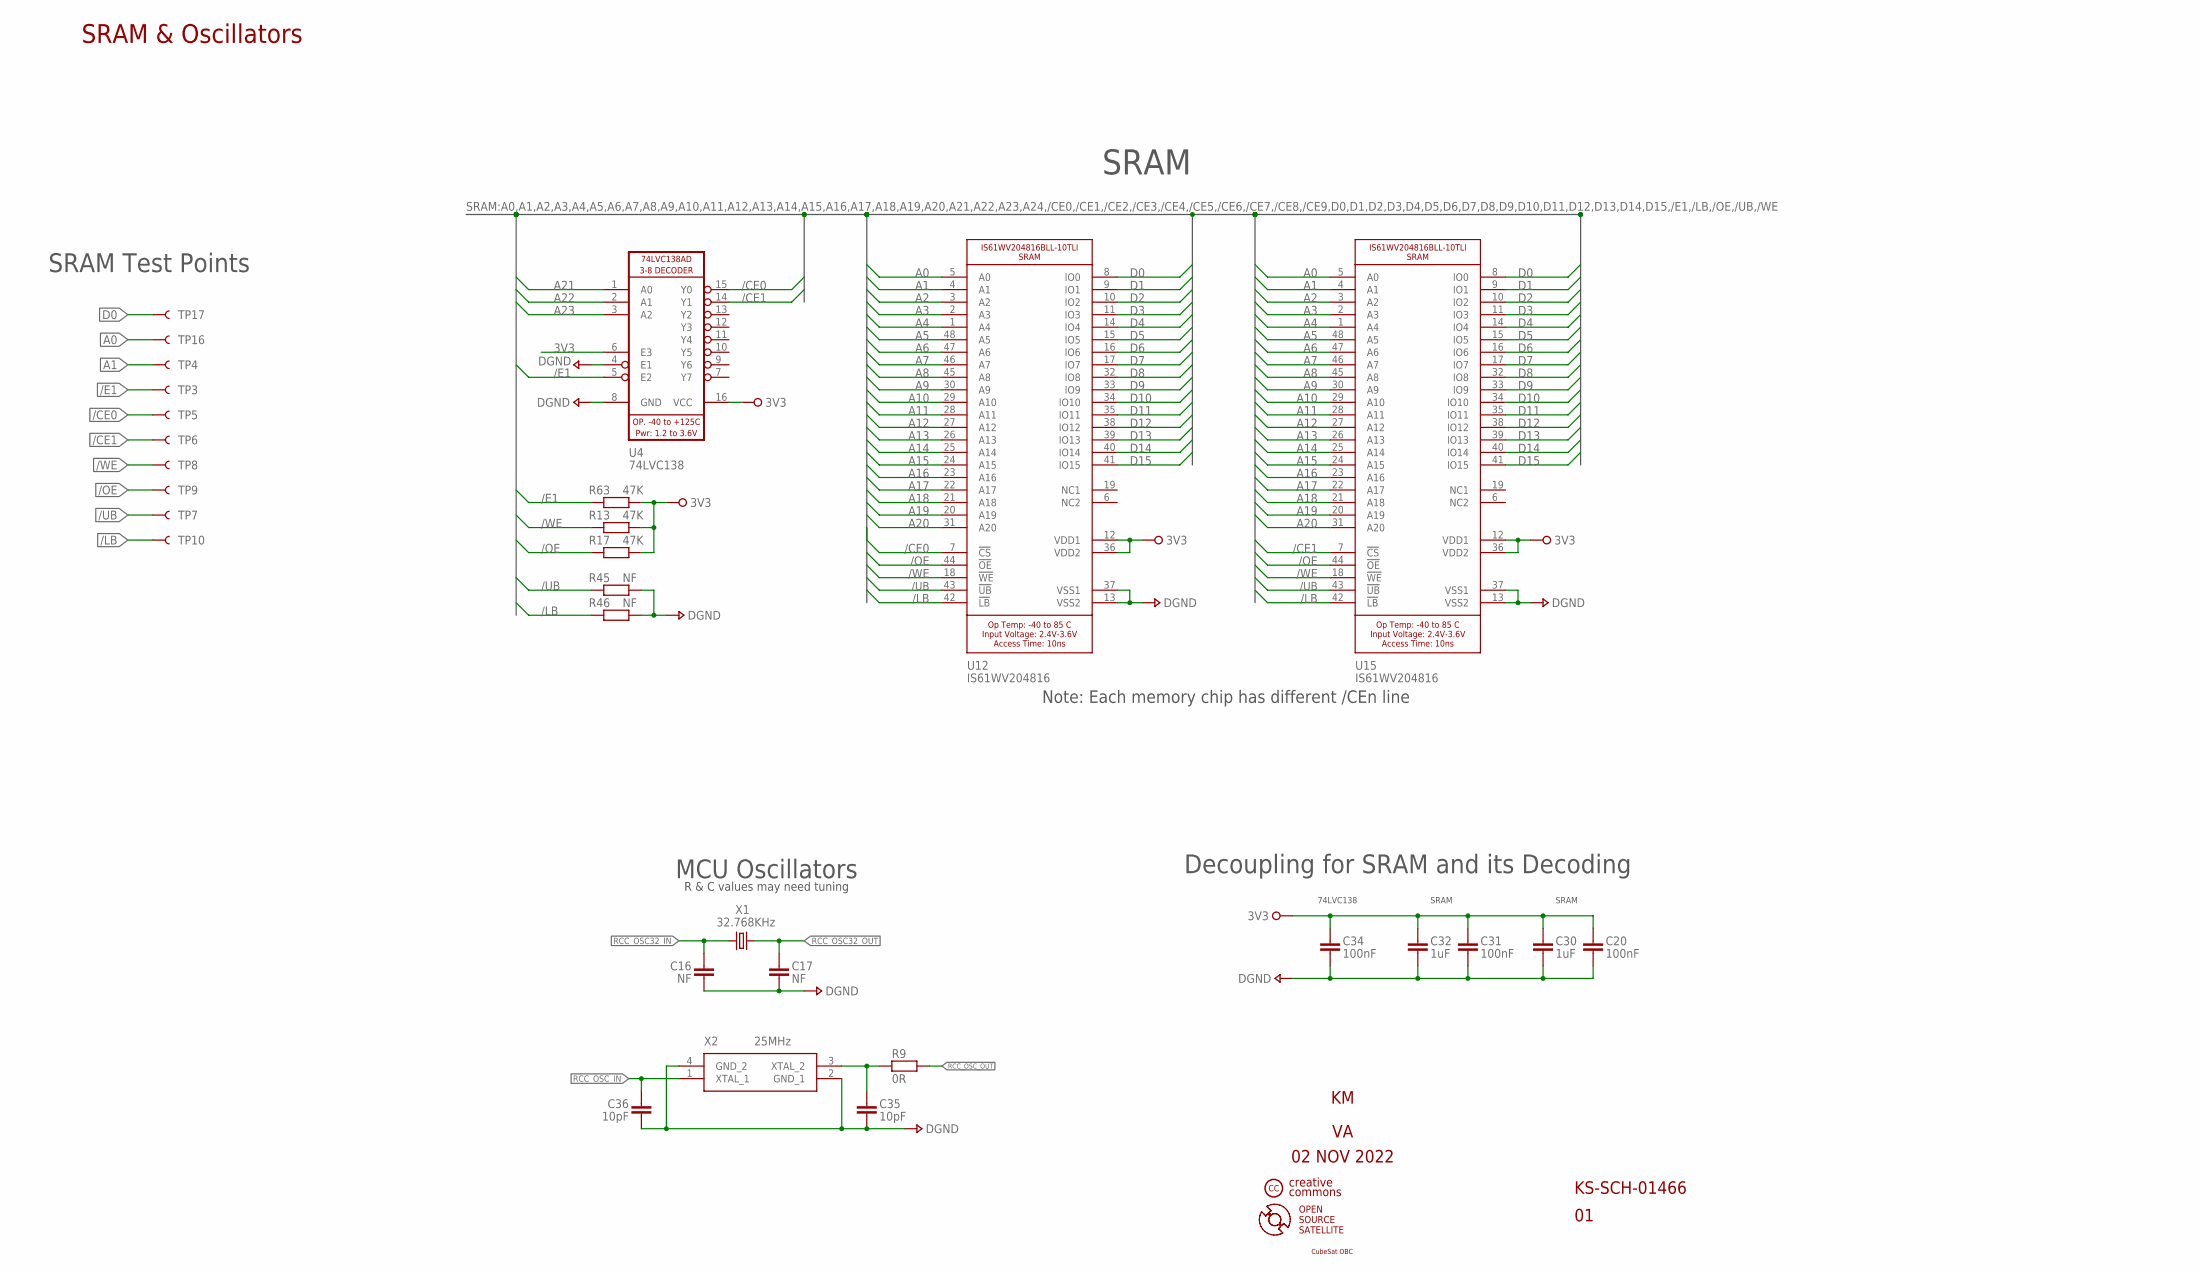
[picture p7: schematic CubeSat_OBC_Schematic.sch, sheet 5, MRAM & OSCILLATORS]

Parts:
C16, C17: NF; CAP_CHIP_0805
C20, C31, C34: 100nF; CAP_CHIP_0805
C30, C32: 1uF; CAP_CHIP_0805
C35, C36: 10pF; CAP_CHIP_0805
R9: 0R; RES_CHIP_0805
R13, R17, R63: 47K; RES_CHIP_0805
R45, R46: NF; RES_CHIP_0805
TP3, TP4, TP5, TP6, TP7, TP8, TP9, TP10, TP16, TP17: NF; TP-40TH
U4: ICTL100A_74LVC138AD_3-8_DECODER; SOIC-16
U12, U15: ICTM101A_IS61WV204816BLL-10TLI_SRAM_4MBYTE; IS61WV204816BLL-10TLI
X1: OSCC100A_XTAL_32.768KHZ_12P5; XTAL_NX3215SA
X2: OSCC102A_XTAL_25MHZ_10PF; XTAL_NX2016SA

Connections:
3V3: C20.1, C30.1, C31.1, C32.1, C34.1, R13.2, R17.2, R63.2, U4.6 (E3), U4.16 (VCC), U12.12 (VDD1), U12.36 (VDD2), U15.12 (VDD1), U15.36 (VDD2); also elsewhere on the board
/CE0: TP5.P$1, U4.15 (Y0), U12.7 (!CS)
/CE1: TP6.P$1, U4.14 (Y1), U15.7 (!CS)
/E1: R63.1, TP3.P$1, U4.5 (E2); also elsewhere on the board
/LB: R46.1, TP10.P$1, U12.42 (!LB), U15.42 (!LB); also elsewhere on the board
/OE: R17.1, TP9.P$1, U12.44 (!OE), U15.44 (!OE); also elsewhere on the board
/UB: R45.1, TP7.P$1, U12.43 (!UB), U15.43 (!UB); also elsewhere on the board
/WE: R13.1, TP8.P$1, U12.18 (!WE), U15.18 (!WE); also elsewhere on the board
A0: TP16.P$1, U12.5 (A0), U15.5 (A0); also elsewhere on the board
A1: TP4.P$1, U12.4 (A1), U15.4 (A1); also elsewhere on the board
A2: U12.3 (A2), U15.3 (A2); also elsewhere on the board
A3: U12.2 (A3), U15.2 (A3); also elsewhere on the board
A4: U12.1 (A4), U15.1 (A4); also elsewhere on the board
A5: U12.48 (A5), U15.48 (A5); also elsewhere on the board
A6: U12.47 (A6), U15.47 (A6); also elsewhere on the board
A7: U12.46 (A7), U15.46 (A7); also elsewhere on the board
A8: U12.45 (A8), U15.45 (A8); also elsewhere on the board
A9: U12.30 (A9), U15.30 (A9); also elsewhere on the board
A10: U12.29 (A10), U15.29 (A10); also elsewhere on the board
A11: U12.28 (A11), U15.28 (A11); also elsewhere on the board
A12: U12.27 (A12), U15.27 (A12); also elsewhere on the board
A13: U12.26 (A13), U15.26 (A13); also elsewhere on the board
A14: U12.25 (A14), U15.25 (A14); also elsewhere on the board
A15: U12.24 (A15), U15.24 (A15); also elsewhere on the board
A16: U12.23 (A16), U15.23 (A16); also elsewhere on the board
A17: U12.22 (A17), U15.22 (A17); also elsewhere on the board
A18: U12.21 (A18), U15.21 (A18); also elsewhere on the board
A19: U12.20 (A19), U15.20 (A19); also elsewhere on the board
A20: U12.31 (A20), U15.31 (A20); also elsewhere on the board
A21: U4.1 (A0); also elsewhere on the board
A22: U4.2 (A1); also elsewhere on the board
A23: U4.3 (A2); also elsewhere on the board
D0: TP17.P$1, U12.8 (IO0), U15.8 (IO0); also elsewhere on the board
D1: U12.9 (IO1), U15.9 (IO1); also elsewhere on the board
D2: U12.10 (IO2), U15.10 (IO2); also elsewhere on the board
D3: U12.11 (IO3), U15.11 (IO3); also elsewhere on the board
D4: U12.14 (IO4), U15.14 (IO4); also elsewhere on the board
D5: U12.15 (IO5), U15.15 (IO5); also elsewhere on the board
D6: U12.16 (IO6), U15.16 (IO6); also elsewhere on the board
D7: U12.17 (IO7), U15.17 (IO7); also elsewhere on the board
D8: U12.32 (IO8), U15.32 (IO8); also elsewhere on the board
D9: U12.33 (IO9), U15.33 (IO9); also elsewhere on the board
D10: U12.34 (IO10), U15.34 (IO10); also elsewhere on the board
D11: U12.35 (IO11), U15.35 (IO11); also elsewhere on the board
D12: U12.38 (IO12), U15.38 (IO12); also elsewhere on the board
D13: U12.39 (IO13), U15.39 (IO13); also elsewhere on the board
D14: U12.40 (IO14), U15.40 (IO14); also elsewhere on the board
D15: U12.41 (IO15), U15.41 (IO15); also elsewhere on the board
DGND: C16.2, C17.2, C20.2, C30.2, C31.2, C32.2, C34.2, C35.2, C36.2, R45.2, R46.2, U4.4 (E1), U4.8 (GND), U12.13 (VSS2), U12.37 (VSS1), U15.13 (VSS2), U15.37 (VSS1), X2.2 (GND_1), X2.4 (GND_2); also elsewhere on the board
unnamed: C35.1, R9.2, X2.3 (XTAL_2)
RCC_OSC32_IN: C16.1, X1.2; also elsewhere on the board
RCC_OSC32_OUT: C17.1, X1.1; also elsewhere on the board
RCC_OSC_IN: C36.1, X2.1 (XTAL_1); also elsewhere on the board
RCC_OSC_OUT: R9.1; also elsewhere on the board

Notes on the sheet:
Note: Each memory chip has different /CEn line
SRAM
Decoupling for SRAM and its Decoding
74LVC138
SRAM & Oscillators
KS-SCH-01466
SRAM Test Points
MCU Oscillators
R & C values may need tuning
02 NOV 2022
OPEN SOURCE SATELLITE
creative commons
CubeSat OBC

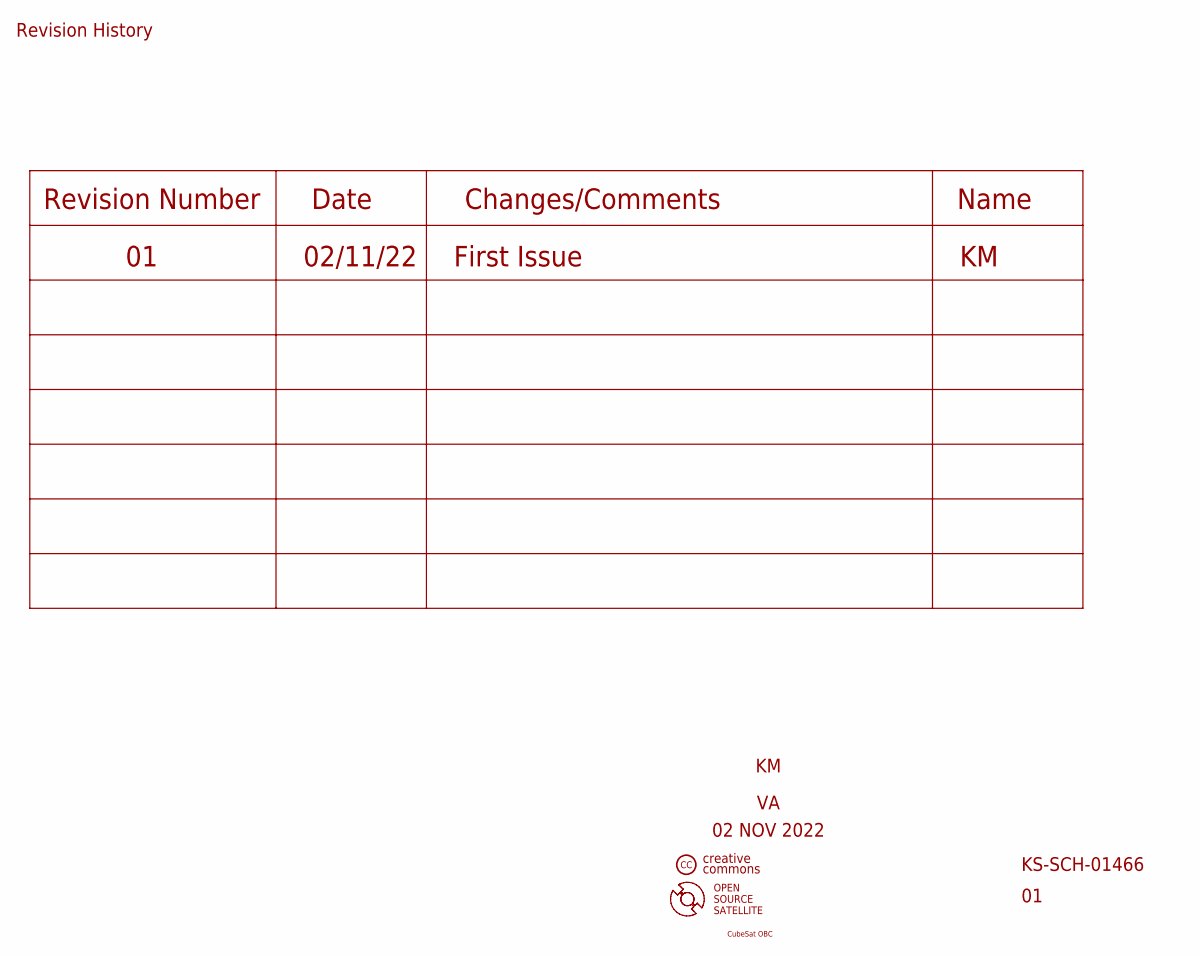
[picture p8: schematic CubeSat_OBC_Schematic.sch, sheet 6, Revision History]

Notes on the sheet:
Revision History
KS-SCH-01466
Revision Number
Date
Changes/Comments
02/11/22
First Issue
Name
02 NOV 2022
OPEN SOURCE SATELLITE
creative commons
CubeSat OBC

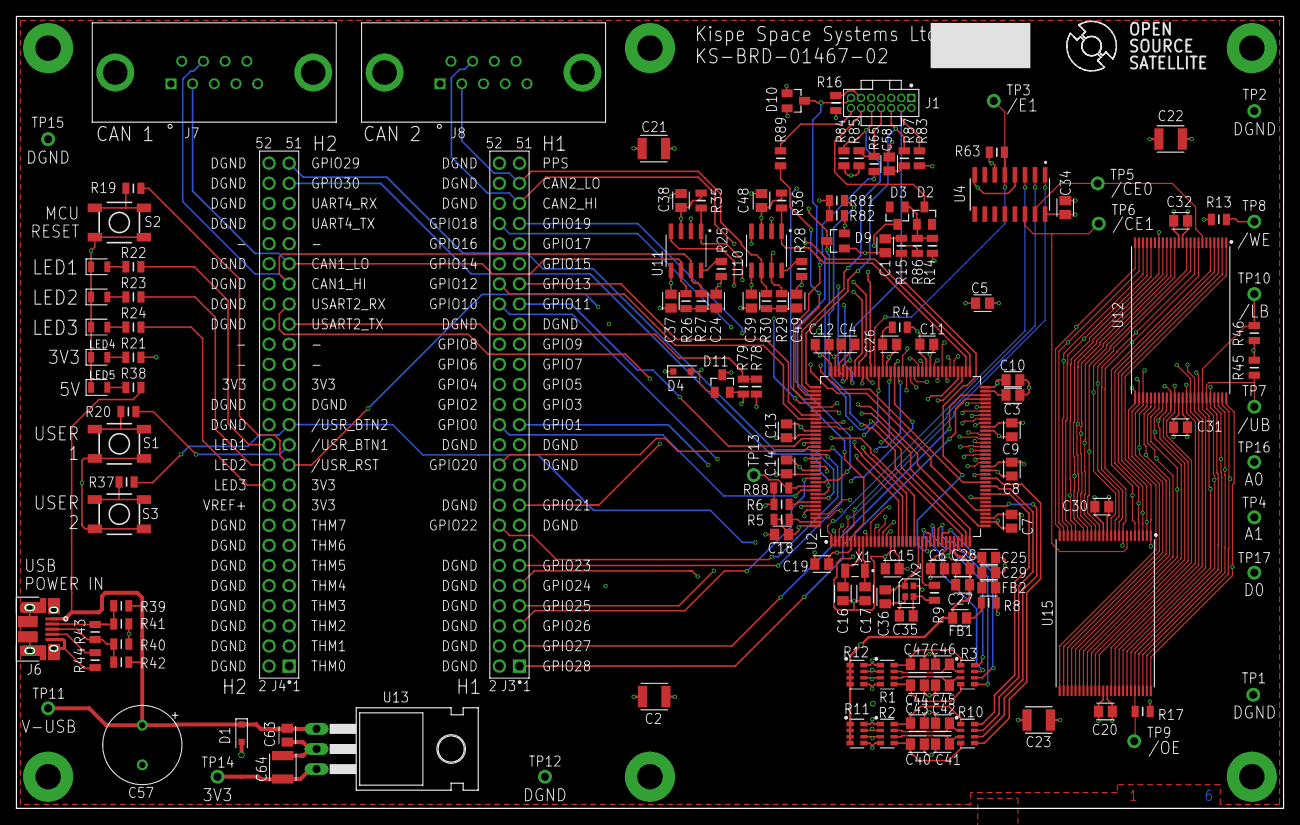
[picture p9: board CubeSat_OBC_PCB.brd from above]

Board: 6 copper layers, 160.0 x 100.0 mm, 160 parts (0 on the bottom side), 169 nets.
