jagobandhusome/STM32_OBC_Cube_Sat_Firmware/CubeSat_OBC_Firmware/CubeSat_OBC.ioc

Mcu.UserName=STM32H753ZITx
PA0.Signal=UART4_TX
PA1.Signal=UART4_RX
PA10.Signal=GPIO_Input
PA11.Signal=FDCAN1_RX
PA12.Signal=FDCAN1_TX
PA2.Signal=USART2_TX
PA3.Signal=USART2_RX
PA5.Signal=GPIO_Input
PA6.Signal=ADCx_INP3
PA8.Signal=GPIO_Output
PA9.Signal=GPIO_Input
PB1.Signal=ADCx_INP5
PB10.Signal=I2C2_SCL
PB11.Signal=I2C2_SDA
PB12.Signal=FDCAN2_RX
PB13.Signal=FDCAN2_TX
PB14.Signal=GPIO_Output
PB15.Signal=GPIO_Output
PB2.Signal=GPIO_Input
PB5.Signal=GPIO_Output
PB6.Signal=I2C1_SCL
PB7.Signal=I2C1_SDA
PB8.Signal=I2C4_SCL
PB9.Signal=I2C4_SDA
PC0.Signal=ADCx_INP10
PC1.Signal=ADCx_INP11
PC10.Signal=USART3_TX
PC11.Signal=USART3_RX
PC12.Signal=GPIO_Input
PC13.Signal=RTC_OUT_CALIB
PC2_C.Signal=ADC3_INP0
PC3_C.Signal=ADC3_INP1
PC4.Signal=GPIO_Output
PC5.Signal=ADCx_INP8
PC6.Signal=GPIO_Input
PC7.Signal=FMC_NE1
PC8.Signal=GPIO_Input
PC9.Signal=GPIO_Output
PD0.Signal=FMC_D2_DA2
PD1.Signal=FMC_D3_DA3
PD10.Signal=FMC_D15_DA15
PD11.Signal=FMC_A16_CLE
PD12.Signal=FMC_A17_ALE
PD13.Signal=FMC_A18
PD14.Signal=FMC_D0_DA0
PD15.Signal=FMC_D1_DA1
PD2.Signal=GPIO_Input
PD3.Signal=GPIO_Input
PD4.Signal=FMC_NOE
PD5.Signal=FMC_NWE
PD6.Signal=GPIO_Input
PD7.Signal=SPI1_MOSI
PD8.Signal=FMC_D13_DA13
PD9.Signal=FMC_D14_DA14
PE0.Signal=FMC_NBL0
PE1.Signal=FMC_NBL1
PE10.Signal=FMC_D7_DA7
PE11.Signal=FMC_D8_DA8
PE12.Signal=FMC_D9_DA9
PE13.Signal=FMC_D10_DA10
PE14.Signal=FMC_D11_DA11
PE15.Signal=FMC_D12_DA12
PE2.Signal=FMC_A23
PE3.Signal=FMC_A19
PE4.Signal=FMC_A20
PE5.Signal=FMC_A21
PE6.Signal=FMC_A22
PE7.Signal=FMC_D4_DA4
PE8.Signal=FMC_D5_DA5
PE9.Signal=FMC_D6_DA6
PF0.Signal=FMC_A0
PF1.Signal=FMC_A1
PF10.Signal=GPIO_Output
PF11.Signal=ADC1_INP2
PF12.Signal=FMC_A6
PF13.Signal=FMC_A7
PF14.Signal=FMC_A8
PF15.Signal=FMC_A9
PF2.Signal=FMC_A2
PF3.Signal=FMC_A3
PF4.Signal=FMC_A4
PF5.Signal=FMC_A5
PF6.Signal=GPIO_Output
PF7.Signal=GPIO_Output
PF8.Signal=GPIO_Output
PF9.Signal=GPIO_Input
PG0.Signal=FMC_A10
PG1.Signal=FMC_A11
PG10.Signal=SPI1_NSS
PG11.Signal=SPI1_SCK
PG12.Signal=GPIO_Input
PG13.Signal=FMC_A24
PG14.Signal=GPIO_Output
PG15.Signal=GPXTI15
PG2.Signal=FMC_A12
PG3.Signal=FMC_A13
PG4.Signal=FMC_A14_BA0
PG5.Signal=FMC_A15_BA1
PG6.Signal=GPIO_Output
PG7.Signal=GPIO_Output
PG8.Signal=GPIO_Output
PG9.Signal=GPXTI9
