jagobandhusome/STM32_OBC_Cube_Sat_Firmware/(commit log)

2026-09-12 Add SOARRSO CubeSat OBC firmware, hardware, and documentation.
    [SOARRSO_CubeSat_OBC_PCB.brd, SOARRSO_CubeSat_OBC_Schematic.sch]
2026-09-13 Changed some component label PIN numbers
    [CubeSat_OBC_PCB.brd, CubeSat_OBC_Schematic.sch, SOARRSO_CubeSat_OBC_Schematic.sch]
