jagobandhusome/STM32_OBC_Cube_Sat_Firmware/(notices)

Notices in the files:
CubeSat_OBC_Hardware/CAD/CubeSat_OBC_Schematic.sch:
LICENSE_DATE: CC BY-SA 4.0: (2022)
parts and their libraries:
KSE-MSC: LICENSE_DATE: © 2022 All Rights Reserved
